MARS-UVA/CustomPDB/TPS62933F_PSPICE_TRANS/TPS62933F_PSPICETransientModel_FeaturesandLimitations.pdf

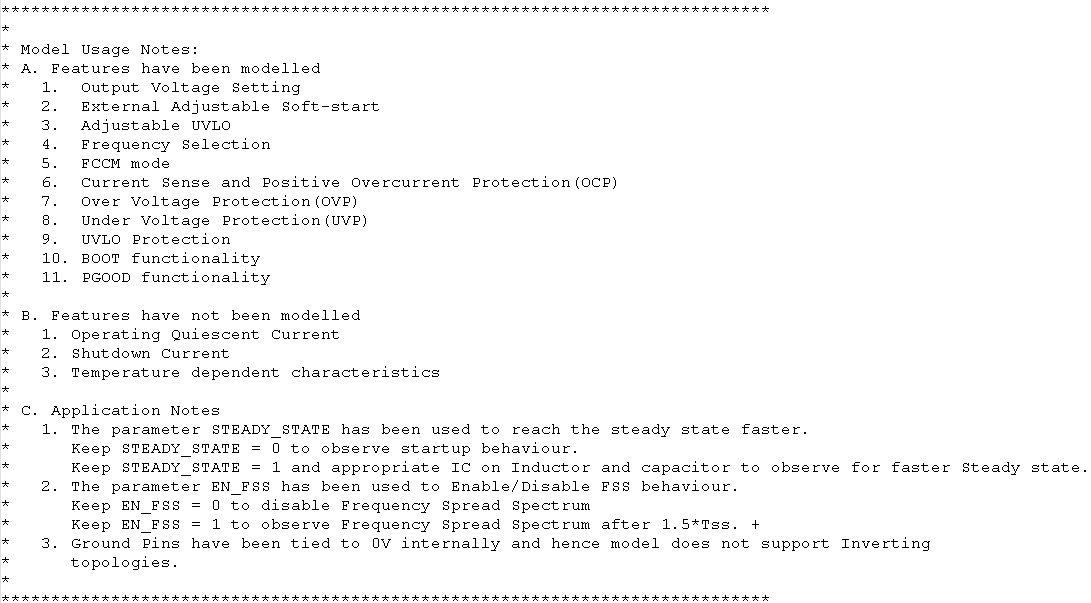
[picture p1: figure]
