MARS-UVA/CustomPDB/TPS62933P_PSPICE_TRANS/TPS62933P_PSPICETransientModel_FeaturesandLimitations.pdf

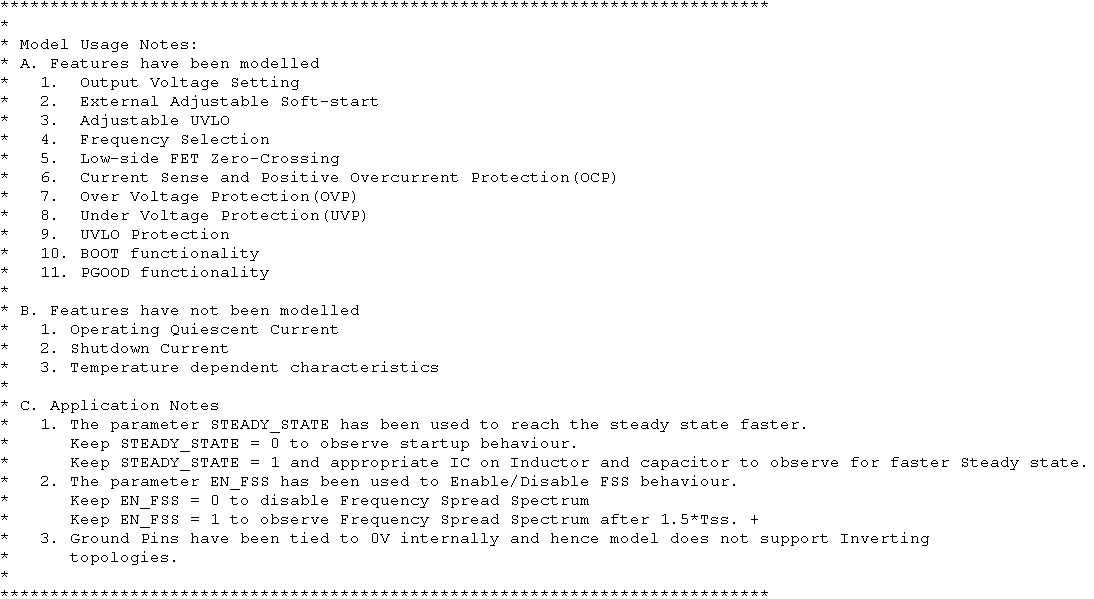
[picture p2: figure]
