MARS-UVA/CustomPDB/(list of files, drawings)

Other design files:
TPS62933_PSPICE_TRANS/TPS62933_TRANS.OPJ
TPS62933_PSPICE_TRANS/TPS62933DRL_TRANS.OLB
TPS62933P_PSPICE_TRANS/TPS62933P_TRANS.opj
TPS62933P_PSPICE_TRANS/TPS62933PDRL_TRANS.OLB
