MARS-UVA/CustomPDB/Power-distribution-board.kicad_pcb

## KiCad design Power-distribution-board.kicad_pcb (2026-10-05)

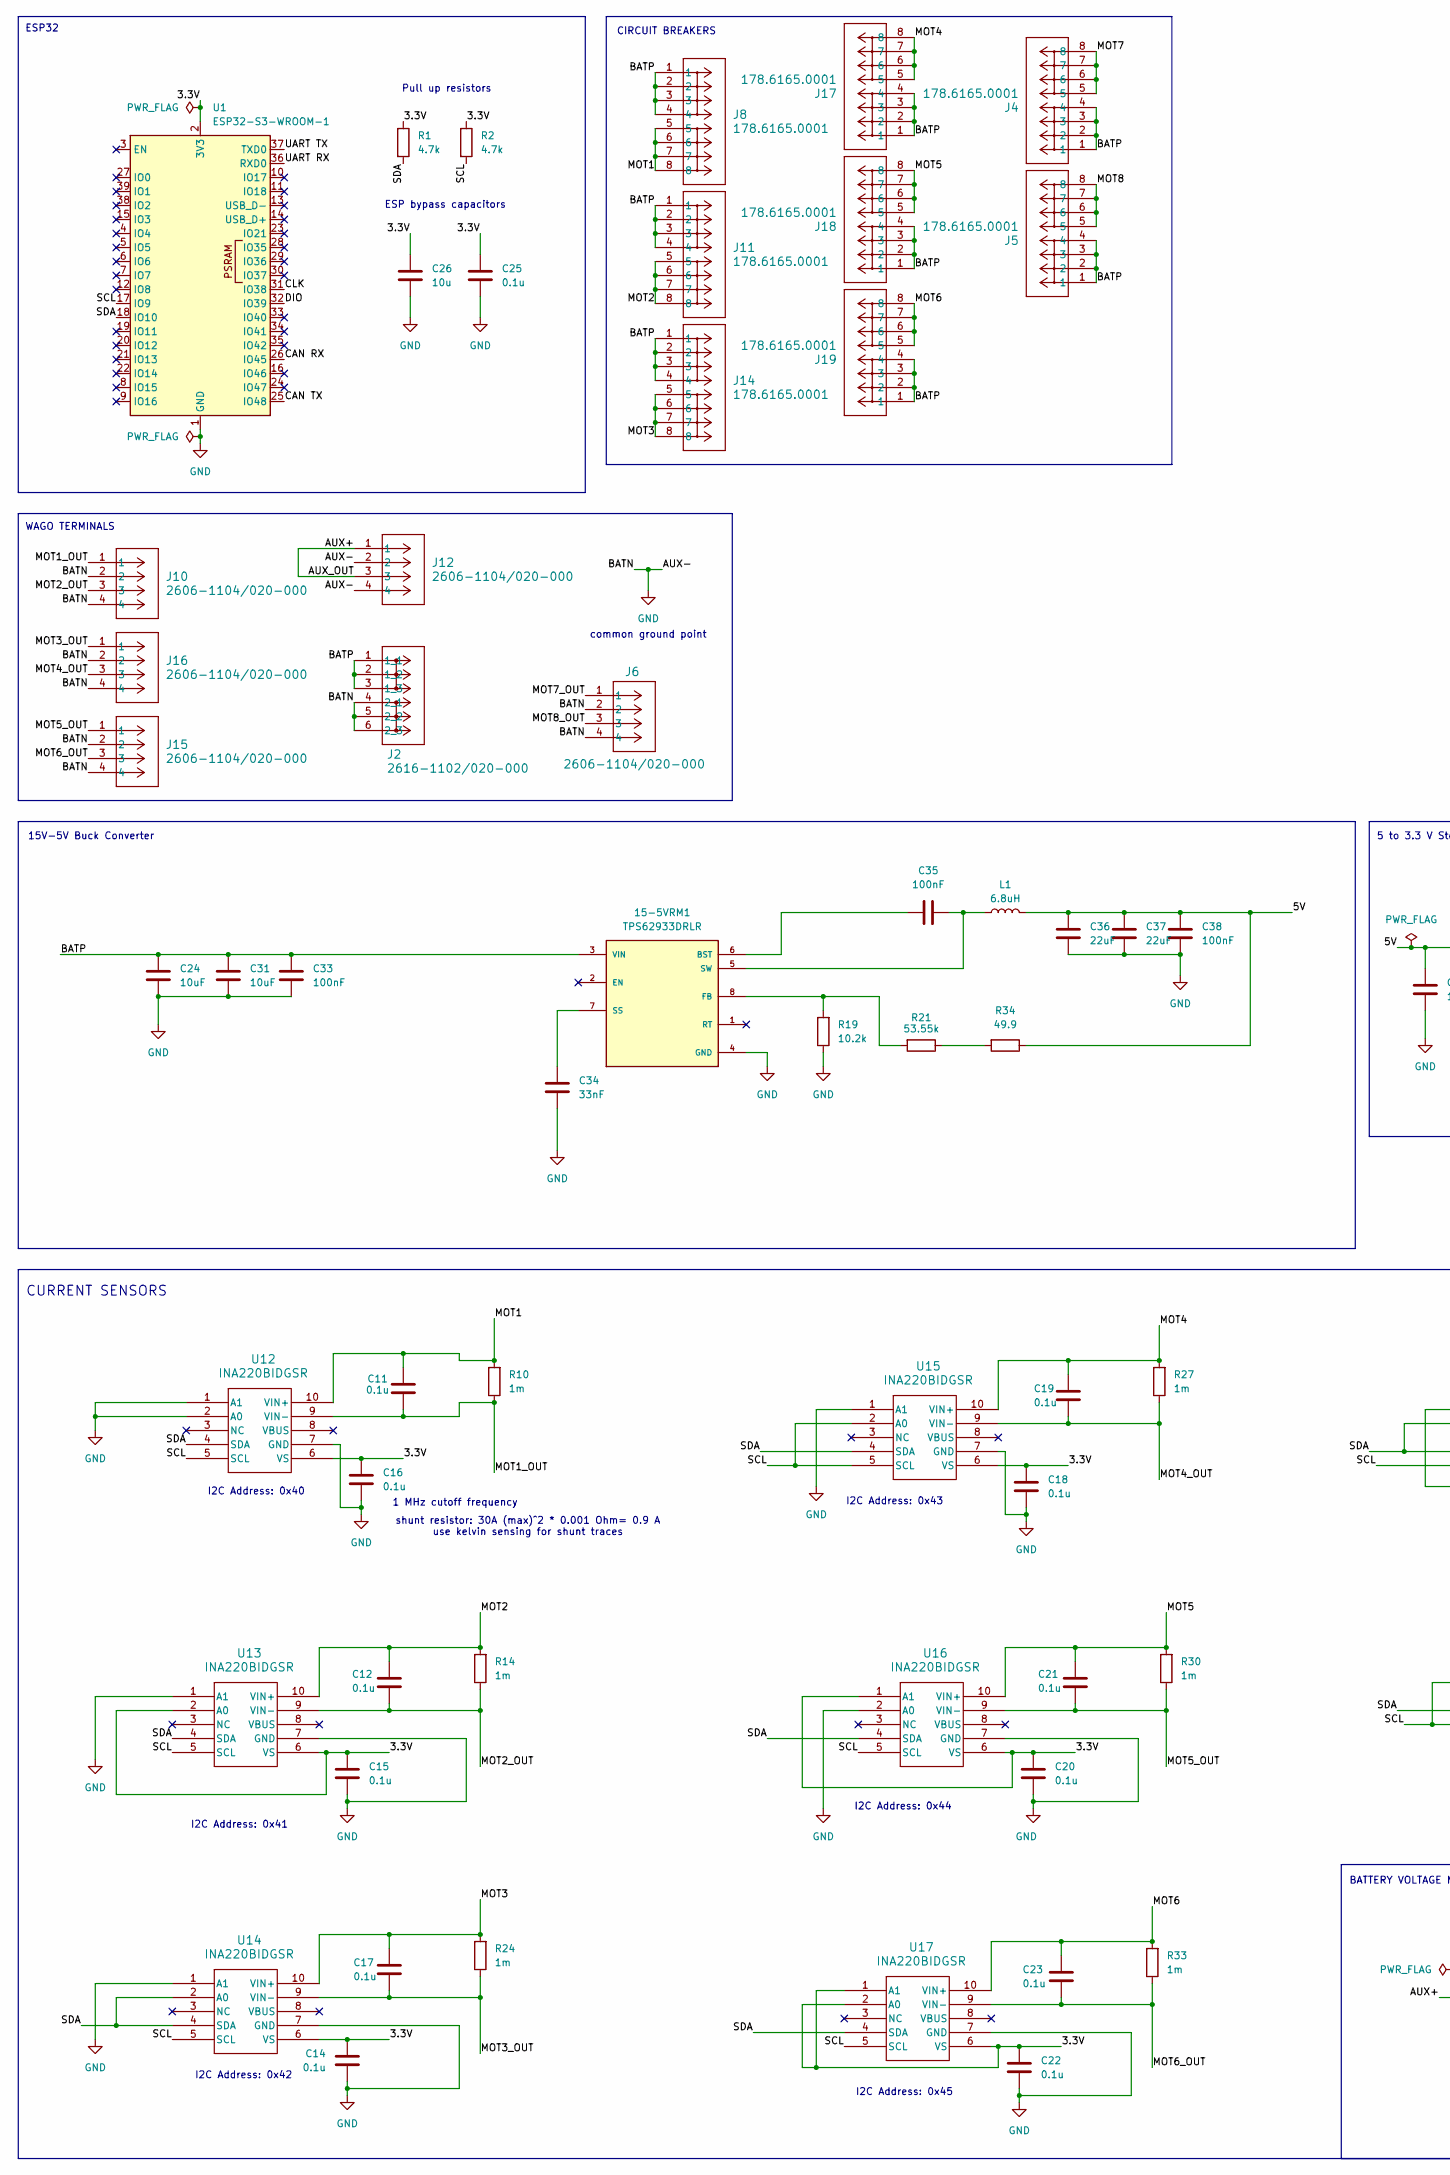
[picture p3: schematic Power-distribution-board.kicad_sch, Lunabotics Power Distribution Board, part in row 1, column 1]

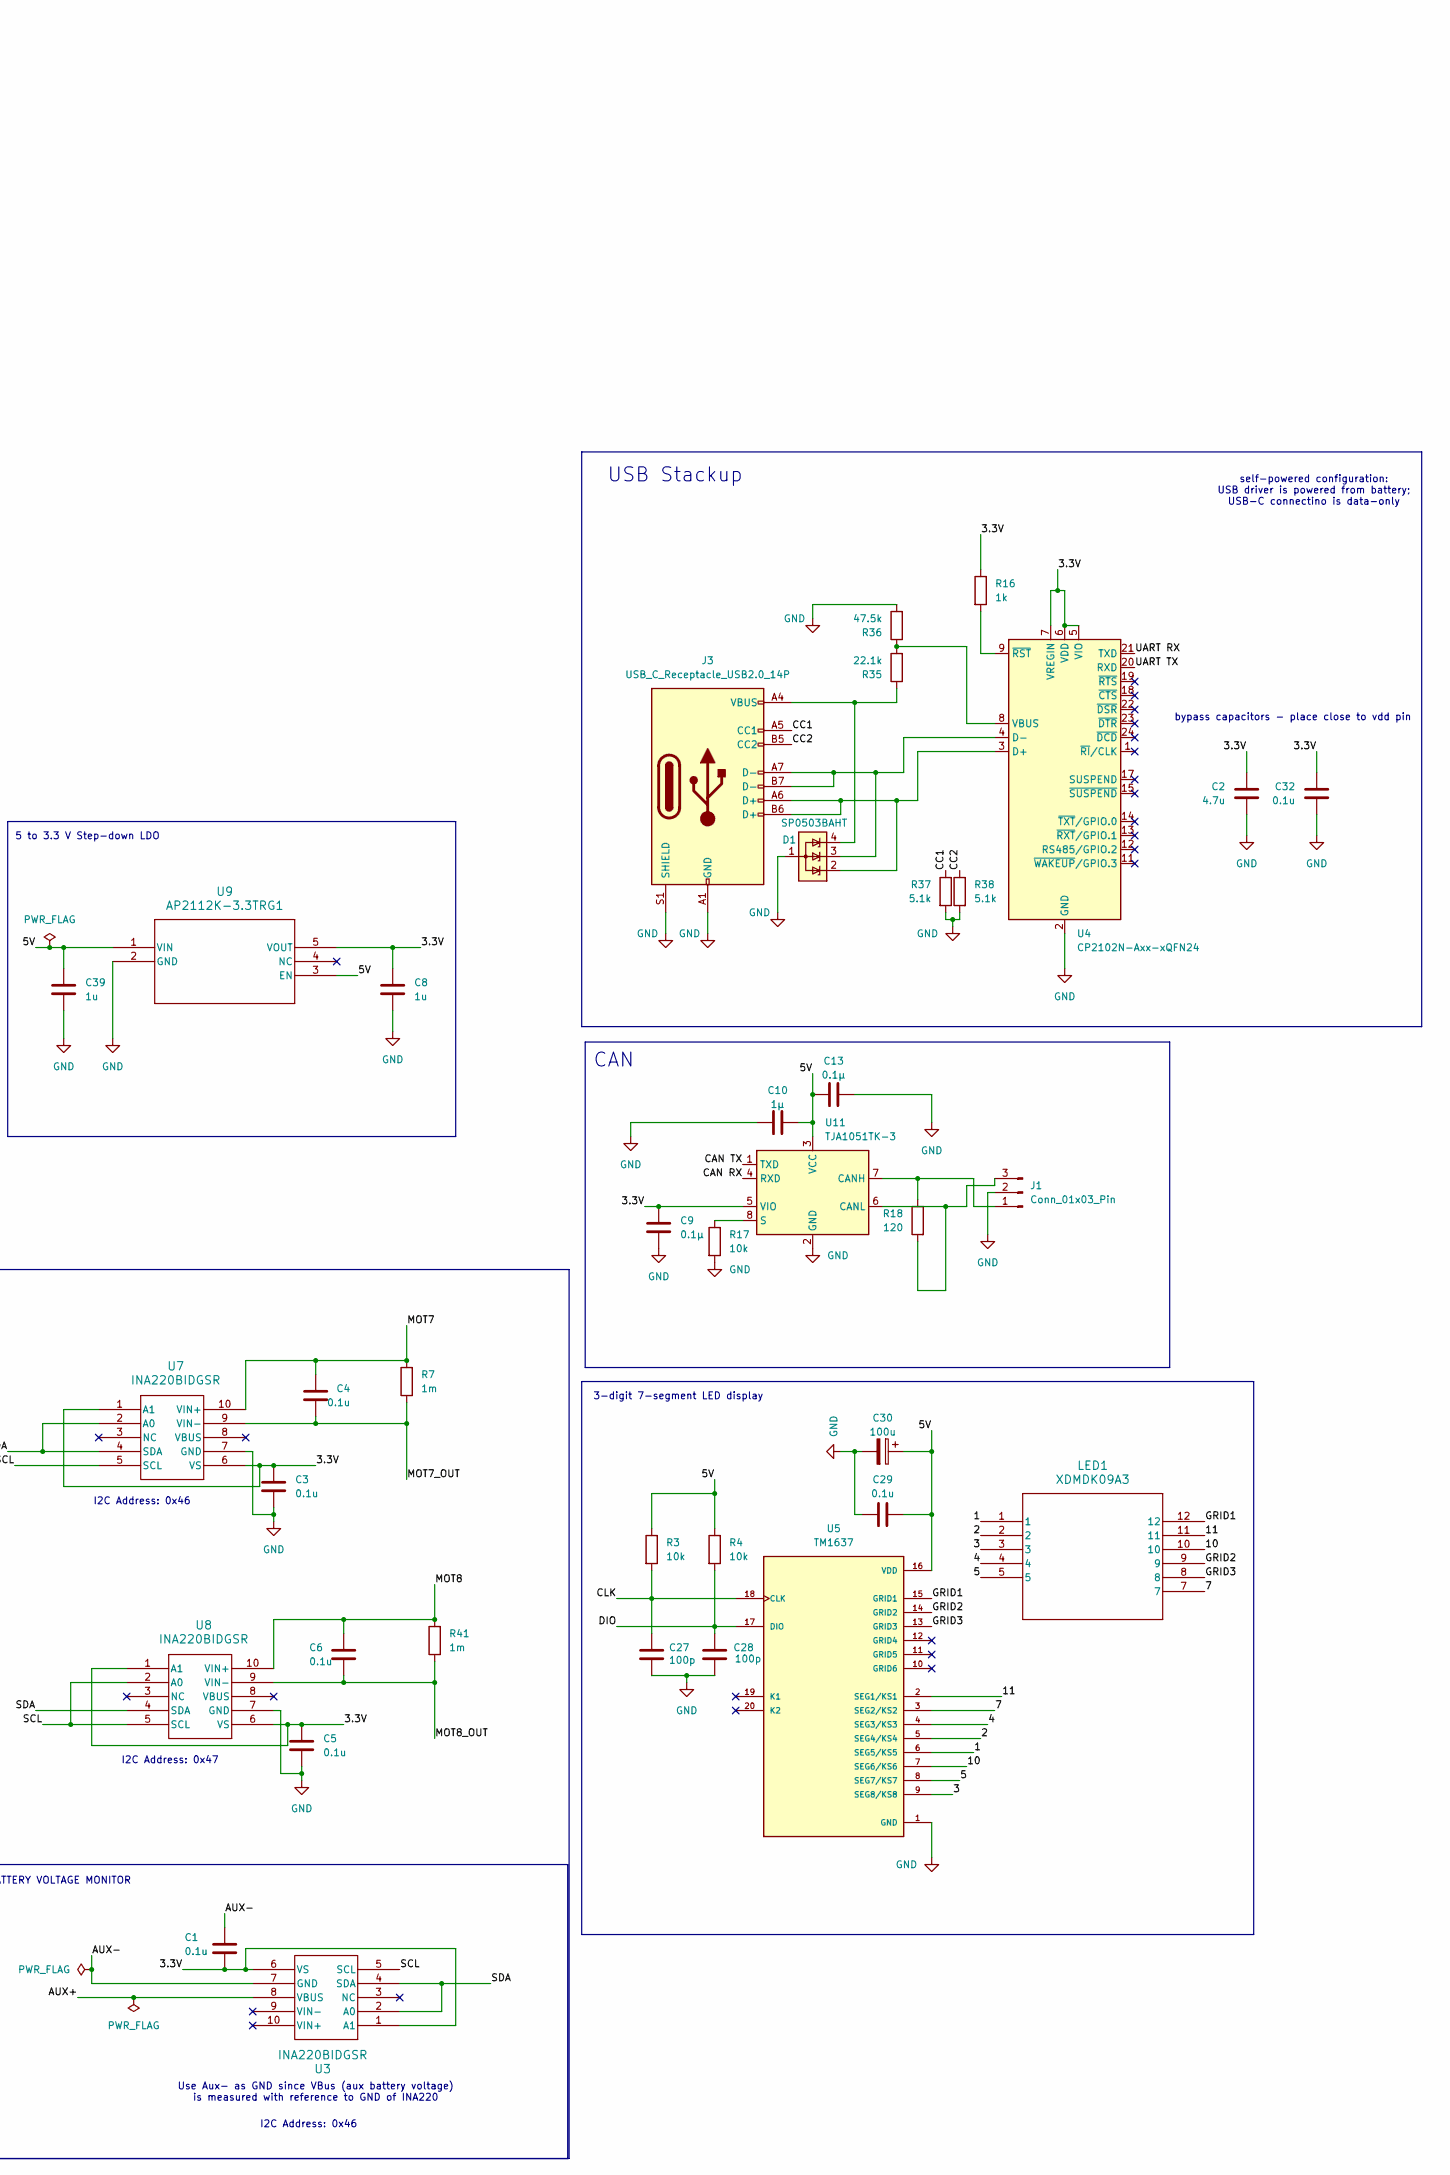
[picture p4: schematic Power-distribution-board.kicad_sch, Lunabotics Power Distribution Board, part in row 1, column 2]

Parts:
15-5VRM1: TPS62933DRLR; SOT-5X3-8_DRL_TEX; PARTREV D
C1, C3, C4, C5, C6, C11, C12, C14, C15, C16, C17, C18, C19, C20, C21, C22, C23, C25, C29, C32: 0.1u; R_0805_2012Metric
C2: 4.7u; C_0805_2012Metric
C8, C39: 1u; C_0805_2012Metric
C9, C13: 0.1µ; C_0805_2012Metric
C10: 1µ; C_0805_2012Metric
C24, C31: 10uF; CAP_CGA5_TDK-M
C26: 10u; C_0805_2012Metric
C27, C28: 100p; C_0805_2012Metric
C30: 100u; CP_Elec_3x5.4
C33, C35, C38: 100nF; C_0805_2012Metric
C34: 33nF; C_0805_2012Metric
C36, C37: 22uF; C_0805_2012Metric
D1: SP0503BAHT; SOT-143
J1: Conn_01x03_Pin; Molex_Micro-Fit_3.0_43650-0300_1x03_P3.00mm_Horizontal
J2: 2616-1102/020-000; CONN2_2616-1102&slash_020-000_WAG
J3: USB_C_Receptacle_USB2.0_14P; USB_C_Receptacle_HRO_TYPE-C-31-M-12
J4, J5, J8, J11, J14, J17, J18, J19: 178.6165.0001; CONN_178.6165.0001_LTF
J6, J10, J12, J15, J16: 2606-1104/020-000; CONN4_2606-1104&slash_020-000_WAG
L1: 6.8uH; L_Wuerth_XHMI-6060
LED1: XDMDK09A3; XDMDK09A3_SLD
R1, R2: 4.7k; R_0402_1005Metric
R3, R4, R17: 10k; R_0402_1005Metric
R7, R10, R14, R24, R27, R30, R33, R41: 1m; RES_3920R_1L00x_BRN-M
R16: 1k; R_0402_1005Metric
R18: 120; R_0402_1005Metric
R19: 10.2k; R_0805_2012Metric
R21: 53.55k; R_0805_2012Metric
R34: 49.9; R_0805_2012Metric
R35: 22.1k; R_0402_1005Metric
R36: 47.5k; R_0402_1005Metric
R37, R38: 5.1k; R_0402_1005Metric
U1: ESP32-S3-WROOM-1
U3, U7, U8, U12, U13, U14, U15, U16, U17: INA220BIDGSR; DGS10
U4: CP2102N-Axx-xQFN24; QFN-24-1EP_4x4mm_P0.5mm_EP2.6x2.6mm
U5: TM1637; LED_driver_DIP778W43P254L2612H431Q20N; PARTREV v2.5
U9: AP2112K-3.3TRG1; SOT_RG1_DIO
U11: TJA1051TK-3; HVSON-8-1EP_3x3mm_P0.65mm_EP1.6x2.4mm

Connections:
/1: LED1.1, U5.6 (SEG5/KS5)
/2: LED1.2, U5.5 (SEG4/KS4)
/3: LED1.3, U5.9 (SEG8/KS8)
/3.3V: C1.1, C2.2, C3.1, C5.1, C8.1, C9.2, C14.1, C15.1, C16.1, C18.1, C20.1, C22.1, C25.2, C26.2, C32.2, R1.1, R2.1, R16.1, U1.2 (3V3), U3.1 (A1), U3.6 (VS), U4.5 (VIO), U4.6 (VDD), U4.7 (VREGIN), U7.1 (A1), U7.6 (VS), U8.1 (A1), U8.6 (VS), U9.5 (VOUT), U11.5 (VIO), U12.6 (VS), U13.2 (A0), U13.6 (VS), U14.6 (VS), U15.6 (VS), U16.1 (A1), U16.6 (VS), U17.1 (A1), U17.2 (A0), U17.6 (VS)
/4: LED1.4, U5.4 (SEG3/KS3)
/5: LED1.5, U5.8 (SEG7/KS7)
/5V: C10.2, C13.1, C29.2, C30.1, C36.1, C37.1, C38.1, C39.1, L1.2, R3.1, R4.1, R34.1, U5.16 (VDD), U9.1 (VIN), U9.3 (EN), U11.3 (VCC)
/7: LED1.7, U5.3 (SEG2/KS2)
/10: LED1.10, U5.7 (SEG6/KS6)
/11: LED1.11, U5.2 (SEG1/KS1)
/AUX+: J12.1, J12.3, U3.8 (VBUS)
/BATP: 15-5VRM1.3 (VIN), C24.1, C31.1, C33.1, J2.1 (1_1), J2.2 (1_2), J2.3 (1_3), J4.1, J4.2, J4.3, J4.4, J5.1, J5.2, J5.3, J5.4, J8.1, J8.2, J8.3, J8.4, J11.1, J11.2, J11.3, J11.4, J14.1, J14.2, J14.3, J14.4, J17.1, J17.2, J17.3, J17.4, J18.1, J18.2, J18.3, J18.4, J19.1, J19.2, J19.3, J19.4
/CAN RX: U1.26 (IO45), U11.4 (RXD)
/CAN TX: U1.25 (IO48), U11.1 (TXD)
/CC1: J3.A5 (CC1), R37.1
/CC2: J3.B5 (CC2), R38.1
/CLK: C27.2, R3.2, U1.31 (IO38), U5.18 (CLK)
/DIO: C28.1, R4.2, U1.32 (IO39), U5.17 (DIO)
/GRID1: LED1.12, U5.15 (GRID1)
/GRID2: LED1.9, U5.14 (GRID2)
/GRID3: LED1.8, U5.13 (GRID3)
/MOT1: C11.1, J8.5, J8.6, J8.7, J8.8, R10.2, U12.10 (VIN+)
/MOT1_OUT: C11.2, J10.1, R10.1, U12.9 (VIN-)
/MOT2: C12.1, J11.5, J11.6, J11.7, J11.8, R14.2, U13.10 (VIN+)
/MOT2_OUT: C12.2, J10.3, R14.1, U13.9 (VIN-)
/MOT3: C17.1, J14.5, J14.6, J14.7, J14.8, R24.2, U14.10 (VIN+)
/MOT3_OUT: C17.2, J16.1, R24.1, U14.9 (VIN-)
/MOT4: C19.1, J17.5, J17.6, J17.7, J17.8, R27.2, U15.10 (VIN+)
/MOT4_OUT: C19.2, J16.3, R27.1, U15.9 (VIN-)
/MOT5: C21.1, J18.5, J18.6, J18.7, J18.8, R30.2, U16.10 (VIN+)
/MOT5_OUT: C21.2, J15.1, R30.1, U16.9 (VIN-)
/MOT6: C23.1, J19.5, J19.6, J19.7, J19.8, R33.2, U17.10 (VIN+)
/MOT6_OUT: C23.2, J15.3, R33.1, U17.9 (VIN-)
/MOT7: C4.1, J4.5, J4.6, J4.7, J4.8, R7.2, U7.10 (VIN+)
/MOT7_OUT: C4.2, J6.1, R7.1, U7.9 (VIN-)
/MOT8: C6.1, J5.5, J5.6, J5.7, J5.8, R41.2, U8.10 (VIN+)
/MOT8_OUT: C6.2, J6.3, R41.1, U8.9 (VIN-)
/SCL: R2.2, U1.17 (IO9), U3.5 (SCL), U7.5 (SCL), U8.2 (A0), U8.5 (SCL), U12.5 (SCL), U13.5 (SCL), U14.5 (SCL), U15.2 (A0), U15.5 (SCL), U16.5 (SCL), U17.5 (SCL)
/SDA: R1.2, U1.18 (IO10), U3.2 (A0), U3.4 (SDA), U7.2 (A0), U7.4 (SDA), U8.4 (SDA), U12.4 (SDA), U13.4 (SDA), U14.2 (A0), U14.4 (SDA), U15.4 (SDA), U16.4 (SDA), U17.4 (SDA)
/UART RX: U1.36 (RXD0), U4.21 (TXD)
/UART TX: U1.37 (TXD0), U4.20 (RXD)
GND: 15-5VRM1.4 (GND), C1.2, C2.1, C3.2, C5.2, C8.2, C9.1, C10.1, C13.2, C14.2, C15.2, C16.2, C18.2, C20.2, C22.2, C24.2, C25.1, C26.1, C27.1, C28.2, C29.1, C30.2, C31.2, C32.1, C33.2, C34.2, C36.2, C37.2, C38.2, C39.2, D1.1 (A), J1.2, J2.4 (2_1), J2.5 (2_2), J2.6 (2_3), J3.A1 (GND), J3.A12 (GND), J3.B1 (GND), J3.B12 (GND), J3.S1 (SHIELD), J6.2, J6.4, J10.2, J10.4, J12.2, J12.4, J15.2, J15.4, J16.2, J16.4, R17.2, R19.1, R36.2, R37.2, R38.2, U1.1 (GND), U1.40 (GND), U1.41 (GND), U3.7 (GND), U4.2 (GND), U4.25 (GND), U5.1 (GND), U7.7 (GND), U8.7 (GND), U9.2 (GND), U11.2 (GND), U11.9 (GND), U12.1 (A1), U12.2 (A0), U12.7 (GND), U13.1 (A1), U13.7 (GND), U14.1 (A1), U14.7 (GND), U15.1 (A1), U15.7 (GND), U16.2 (A0), U16.7 (GND), U17.7 (GND)
unnamed: 15-5VRM1.6 (BST), C35.2
unnamed: 15-5VRM1.8 (FB), R19.2, R21.2
unnamed: 15-5VRM1.7 (SS), C34.1
unnamed: 15-5VRM1.5 (SW), C35.1, L1.1
unnamed: D1.4 (K), J3.A4 (VBUS), J3.A9 (VBUS), J3.B4 (VBUS), J3.B9 (VBUS), R35.1
unnamed: J1.1, R18.1, U11.7 (CANH)
unnamed: J1.3, R18.2, U11.6 (CANL)
unnamed: R21.1, R34.2
unnamed: D1.2 (K), J3.A6 (D+), J3.B6 (D+), U4.3 (D+)
unnamed: D1.3 (K), J3.A7 (D-), J3.B7 (D-), U4.4 (D-)
unnamed: R35.2, R36.1, U4.8 (VBUS)
unnamed: R16.2, U4.9 (~RST)
unnamed: R17.1, U11.8 (S)

Notes on the sheet:
ESP bypass capacitors
I2C Address: 0x45
shunt resistor: 30A (max)^2 * 0.001 Ohm= 0.9 A use kelvin sensing for shunt traces
3-digit 7-segment LED display
bypass capacitors - place close to vdd pin
I2C Address: 0x41
I2C Address: 0x44
1 MHz cutoff frequency
Pull up resistors
15V-5V Buck Converter
I2C Address: 0x42
ESP32
I2C Address: 0x46
BATTERY VOLTAGE MONITOR
CAN
self-powered configuration: USB driver is powered from battery; USB-C connectino is data-only
I2C Address: 0x43
WAGO TERMINALS
5 to 3.3 V Step-down LDO
CURRENT SENSORS
I2C Address: 0x40
CIRCUIT BREAKERS
I2C Address: 0x47
USB Stackup
I2C Address: 0x46
common ground point
Use Aux- as GND since VBus (aux battery voltage) is measured with reference to GND of INA220

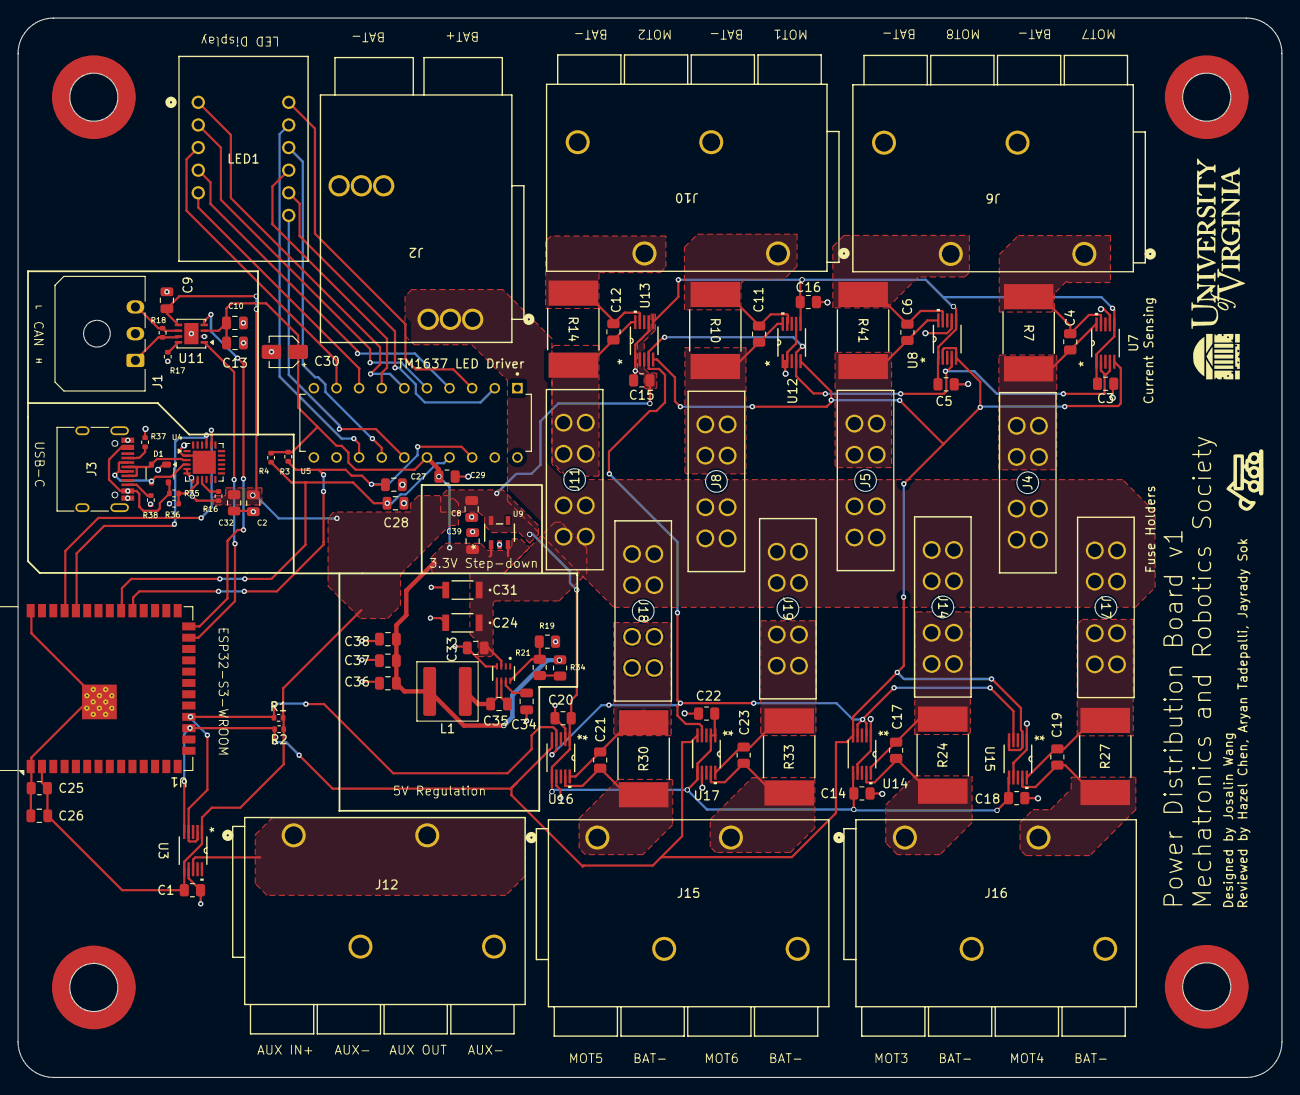
[picture p5: board Power-distribution-board.kicad_pcb from above]

Board: 2 copper layers, 142.0 x 119.0 mm, 94 parts (0 on the bottom side), 55 nets.
