MARS-UVA/CustomPDB/(commit log)

2026-03-10 schematic of buck converter 15v to 5v for esp
    [15v_5v_buck.kicad_sch]
2026-03-20 add current sensors and CAN
    still left to complete: battery voltage, aux battery circuit, esp
    [Power-distribution-board.kicad_sch]
2026-04-07 FINISHED schematic
    [Power-distribution-board.kicad_sch]
2026-04-10 Create project files
    [Power-distribution-board.kicad_pcb, Power-distribution-board.kicad_sch]
2026-04-10 Created KiCad Project
    [Power-distribution-board.kicad_pcb]
2026-04-10 Revert "Create project files"
    This reverts commit bf36d6aff1839375a85b6a2cefe588a7d128445d.
    [Power-distribution-board.kicad_pcb, Power-distribution-board.kicad_sch]
2026-04-10 Updated connectors and started resistor values
    [Power-distribution-board.kicad_sch]
2026-04-27 Update INA220 circuit
    [Power-distribution-board.kicad_sch]
2026-04-28 Finalize INA220 circuits
    [Power-distribution-board.kicad_sch]
2026-04-28 changed 15-5v buck converter and fix current sensors
    [Power-distribution-board.kicad_sch]
2026-04-28 Finalize schematics
    [Power-distribution-board.kicad_sch]
2026-05-01 Changed breaker labels and added all footprints
    [15v_5v_buck.kicad_sch, Power-distribution-board.kicad_pcb, Power-distribution-board.kicad_sch]
2026-05-01 fixed footprints error, begun pcb design
    added footprints into project and started pcb design
    [Power-distribution-board.kicad_pcb, Power-distribution-board.kicad_sch]
2026-06-19 work on pcb editor
    changed layout of components, changed to 4 layer pcb, set minimum trace width 0.2mm
    [Power-distribution-board.kicad_pcb, Power-distribution-board.kicad_sch]
2026-06-19 set layout
    [Power-distribution-board.kicad_pcb, Power-distribution-board.kicad_sch]
2026-06-21 update layout
    added board edge and planes
    [Power-distribution-board.kicad_pcb, Power-distribution-board.kicad_sch]
2026-06-28 added 4-digit display & pwr planes
    add 4digit led and tm1637 driver
    [Power-distribution-board.kicad_pcb, Power-distribution-board.kicad_sch]
2026-06-28 added 15vin pwr plane cus i forgot
    [Power-distribution-board.kicad_pcb]
2026-07-14 traces done
    has some error and warnings tho
    [Power-distribution-board.kicad_pcb, Power-distribution-board.kicad_sch]
2026-08-05 fixed design rules errors
    [Power-distribution-board.kicad_pcb, Power-distribution-board.kicad_sch]
2026-08-28 schematic changes from austen
    [Power-distribution-board-B_Cu.gbr, Power-distribution-board-B_Mask.gbr, Power-distribution-board-B_Paste.gbr, Power-distribution-board-B_Silkscreen.gbr, Power-distribution-board-Edge_Cuts.gbr, Power-distribution-board-F_Cu.gbr, Power-distribution-board-F_Mask.gbr, Power-distribution-board-F_Paste.gbr]
2026-08-30 redid layout
    implemented some of austens advice. changes:
    - correct symbol and footprint used for fuse holders
    - correct orientation of usb port
    - more compact design?
    - placement of current sensors is closer to their respective motor connections
    - pwr planes utilize whole board space for heat dissipation
    notes -
    - need help doing traces. need to figure out how to trace to treat high current optimally
    [Power-distribution-board.kicad_pcb, Power-distribution-board.kicad_sch]
2026-08-30 started routing
    [Power-distribution-board.kicad_pcb]
2026-09-09 cleaned up repo
    [Power-distribution-board-B_Cu.gbr, Power-distribution-board-B_Mask.gbr, Power-distribution-board-B_Paste.gbr, Power-distribution-board-B_Silkscreen.gbr, Power-distribution-board-Edge_Cuts.gbr, Power-distribution-board-F_Cu.gbr, Power-distribution-board-F_Mask.gbr, Power-distribution-board-F_Paste.gbr]
2026-09-09 Fixed schematic
    -shunt resistor changed to 0.1mO that can handle 8W
    -change R10 values to R0 in current sensing circuit
    -flip gnd down (convention)
    -CAN: get rid of switch; replace with short
    -new buck converter for 15v-5v instead of LDO
    -updated footprints
    [Power-distribution-board.kicad_pcb, Power-distribution-board.kicad_sch]
2026-09-10 update schematic and pcb
    - add pull up resistors for sda and scl
    - added buck converter to pcb layout
    - batp & batn planes top and bottom
    [Power-distribution-board.kicad_pcb, Power-distribution-board.kicad_sch]
2026-09-15 updated version
    -added common ground point for aux-, batn, and signal gnd
    -changed usb stackup so usb is powered by LDO 3v3
    -changed wago terminal for battery (rated 60A)
    [Power-distribution-board.kicad_pcb, Power-distribution-board.kicad_sch]
2026-09-29 much progress has been made
    layout is complete. looks very geometrlic. : -D
    [Power-distribution-board.kicad_pcb, Power-distribution-board.kicad_sch]
2026-09-30 ts is ready for routing
    yayy
    [Power-distribution-board.kicad_pcb, Power-distribution-board.kicad_sch]
2026-09-30 commit before tracing
    shorted the battery fuse
    [Power-distribution-board.kicad_pcb, Power-distribution-board.kicad_sch]
2026-10-01 finished traces
    only errors left are courtyard problems -- i just need to fix the footprint
    [Power-distribution-board.kicad_pcb, Power-distribution-board.kicad_sch]
2026-10-01 fixed pcb issues and added silkscreen edits
    fixed long traces breaking up gnd plane
    - added designer and reviewer names
    - added uva logo and mars logo
    [Power-distribution-board.kicad_pcb]
2026-10-05 final changes
    resolved all DRC errors
    -fixed courtyard footprint wago errors
    -extended left side more so more space
    -rerouted differential traces
    -fixed motor pours lol
    [Power-distribution-board.kicad_pcb, Power-distribution-board.kicad_sch]
2026-11-11 15v-12v-modification
    Initial Commit of 15v-12v, 1A buck Convertor
